mahershaikh1/SAVI_Capstone/PCB_Screenshot.png

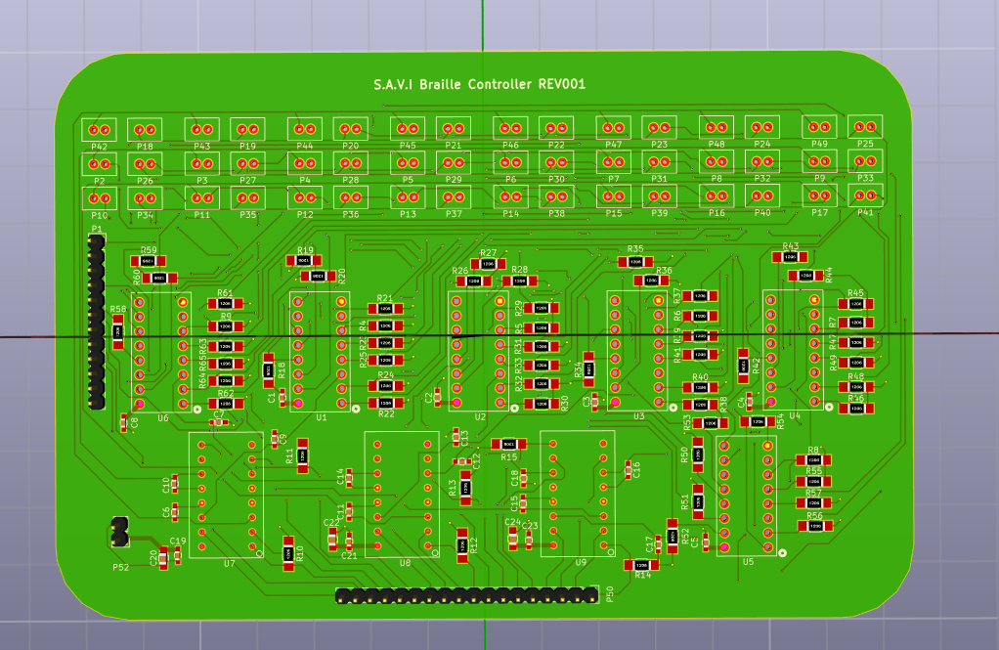
PCB_Screenshot.png
