mahershaikh1/SAVI_Capstone/README.md

# SAVI_Capstone
Smartphone Assistant for the Visually Impaired capstone project. Placed 3rd in the Computer and Electrical Engineering Department.
