mahershaikh1/SAVI_Capstone/Case_SolidWorks/CaseBottom.SLDPRT

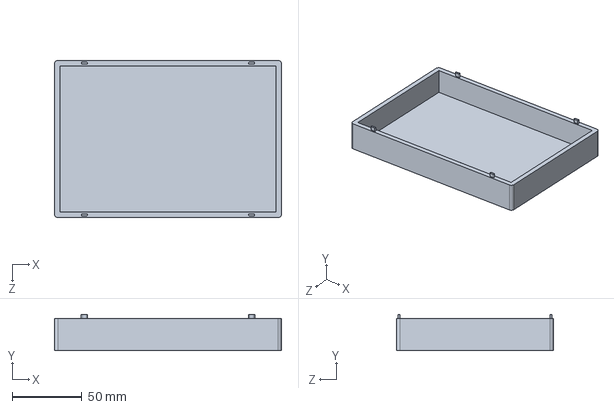
[picture p20: CAD file, 2018-03-02]
Case_SolidWorks/CaseBottom.SLDPRT
163.0 x 26.0 x 113.0 mm
