mahershaikh1/SAVI_Capstone/Pin_Mechanism_stl_files/pin_05.STL

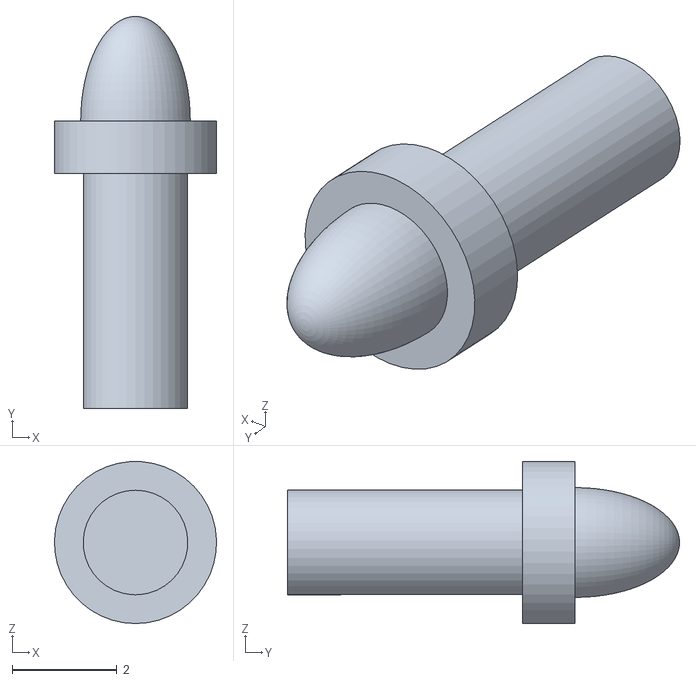
[picture p21: CAD file, 2018-03-02]
Pin_Mechanism_stl_files/pin_05.STL
3.10 x 7.50 x 3.10
