mahershaikh1/SAVI_Capstone/Case_SolidWorks/CaseMiddle.SLDPRT

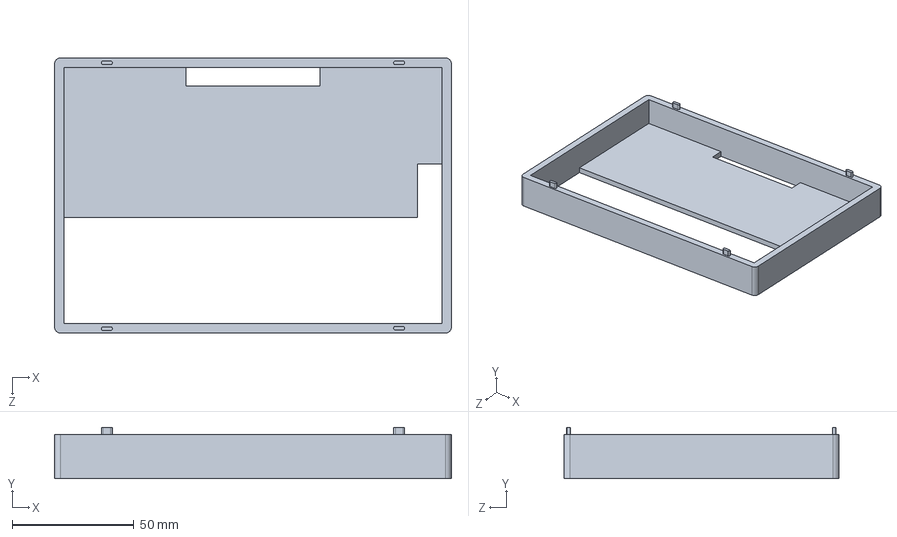
[picture p22: CAD file, 2018-03-02]
Case_SolidWorks/CaseMiddle.SLDPRT
163.0 x 21.0 x 113.0 mm
