mahershaikh1/SAVI_Capstone/Pin_Mechanism_stl_files/fin_0235.STL

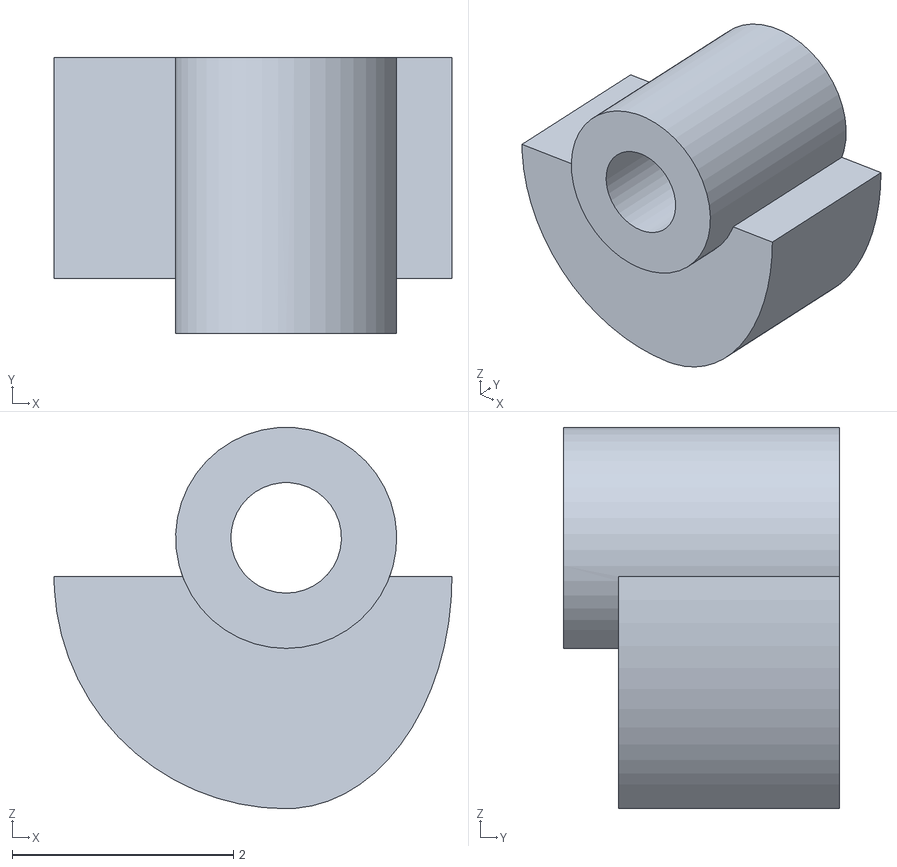
[picture p23: CAD file, 2018-03-02]
Pin_Mechanism_stl_files/fin_0235.STL
3.60 x 2.50 x 3.45
