mahershaikh1/SAVI_Capstone/Case_SolidWorks/CaseTop.SLDPRT

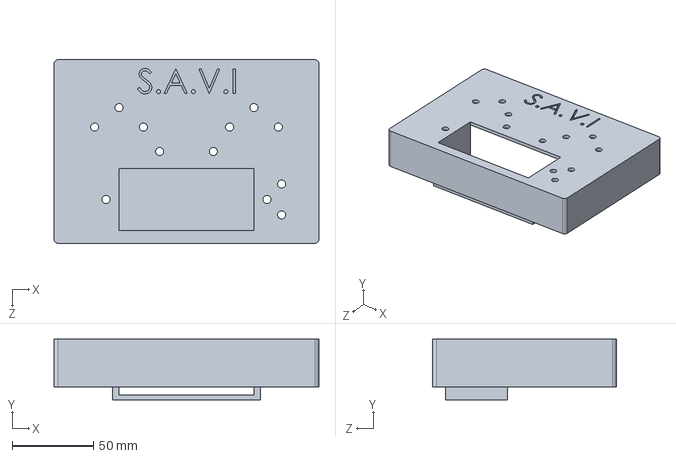
[picture p24: CAD file, 2018-03-02]
Case_SolidWorks/CaseTop.SLDPRT
163.0 x 37.5 x 113.0 mm
