mahershaikh1/SAVI_Capstone/Pin_Mechanism_stl_files/Top_Cover.STL

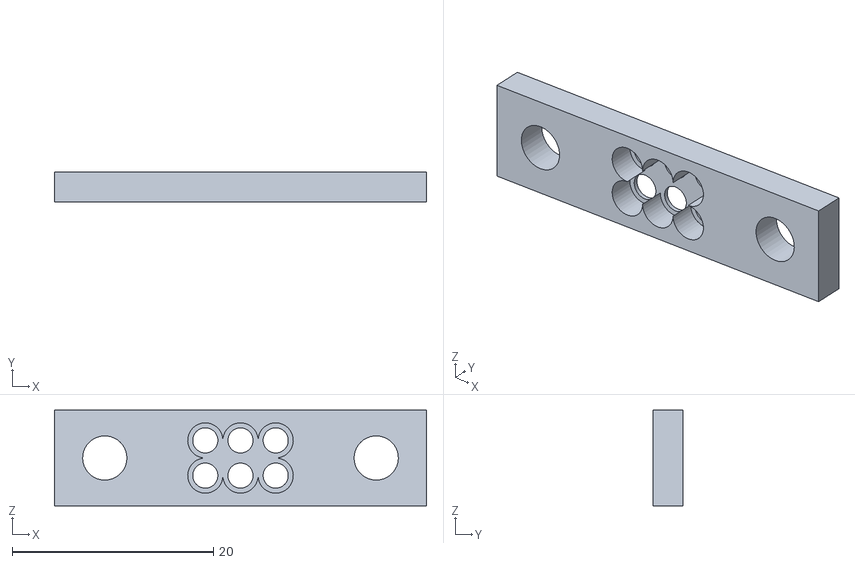
[picture p25: CAD file, 2018-03-02]
Pin_Mechanism_stl_files/Top_Cover.STL
37.0 x 3.00 x 9.50
