mahershaikh1/SAVI_Capstone/Pin_Mechanism_stl_files/pin_1.STL

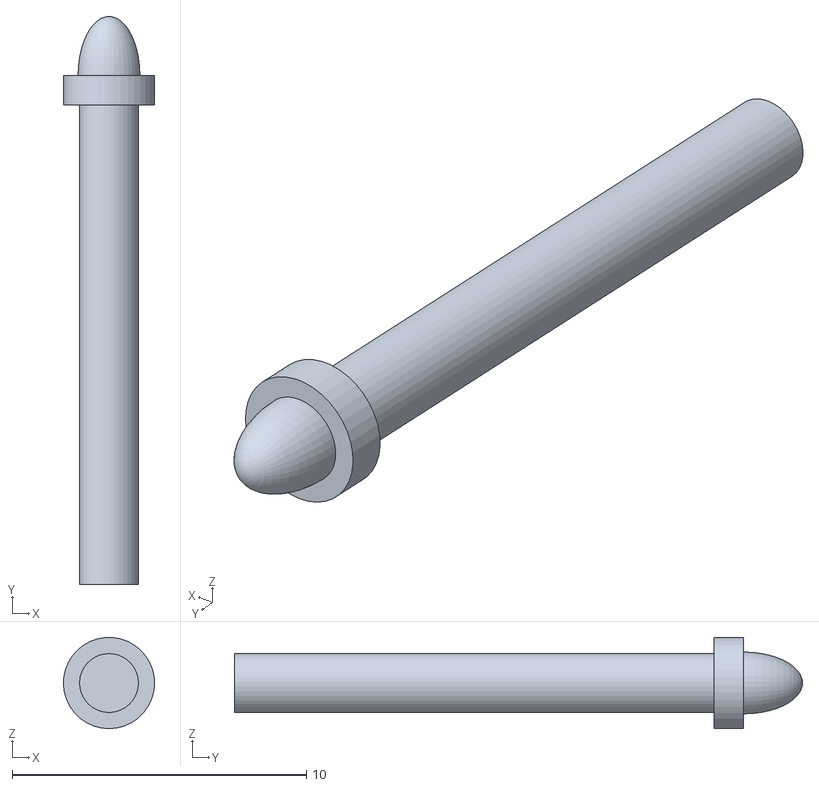
[picture p26: CAD file, 2018-03-02]
Pin_Mechanism_stl_files/pin_1.STL
3.10 x 19.3 x 3.10
