mahershaikh1/SAVI_Capstone/Pin_Mechanism_stl_files/pin_23.STL

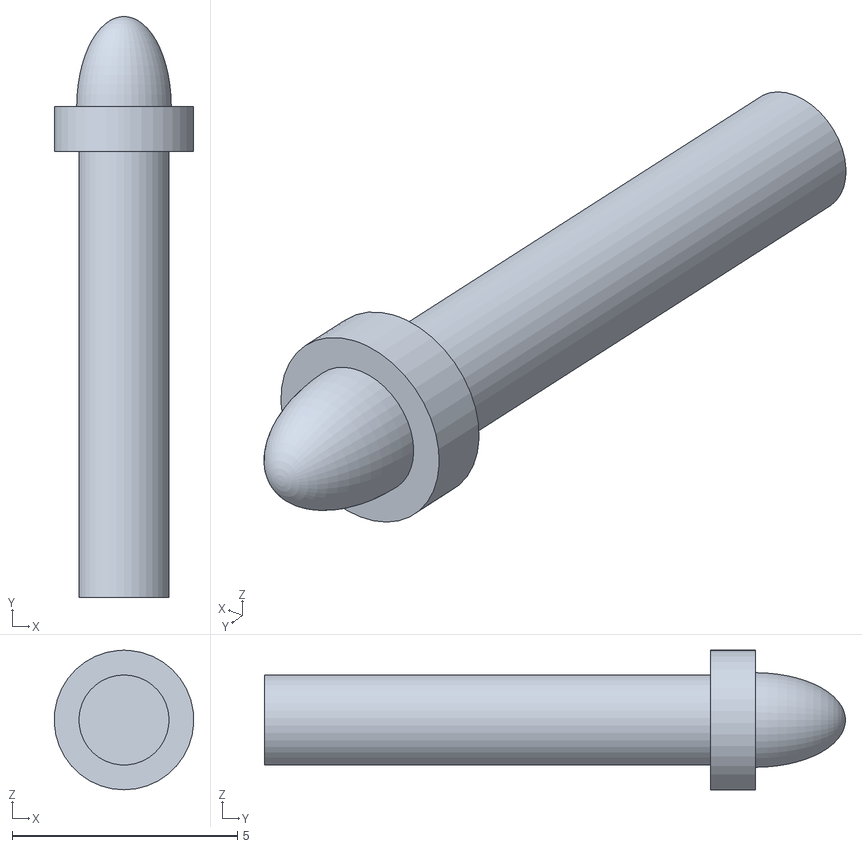
[picture p27: CAD file, 2018-03-02]
Pin_Mechanism_stl_files/pin_23.STL
3.10 x 12.9 x 3.10
