mahershaikh1/SAVI_Capstone/Pin_Mechanism_stl_files/back cover.STL

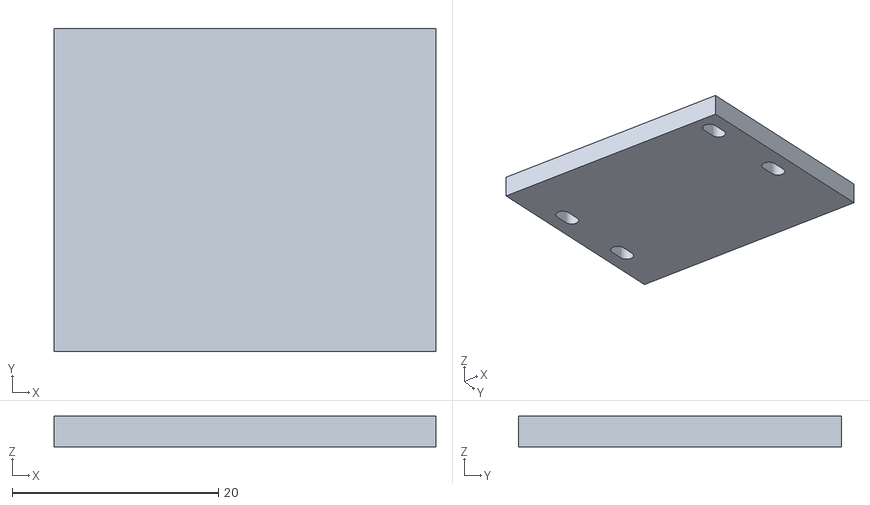
[picture p28: CAD file, 2018-03-02]
Pin_Mechanism_stl_files/back cover.STL
37.0 x 31.3 x 3.00
