mahershaikh1/SAVI_Capstone/Pin_Mechanism_stl_files/housing_middle2.STL

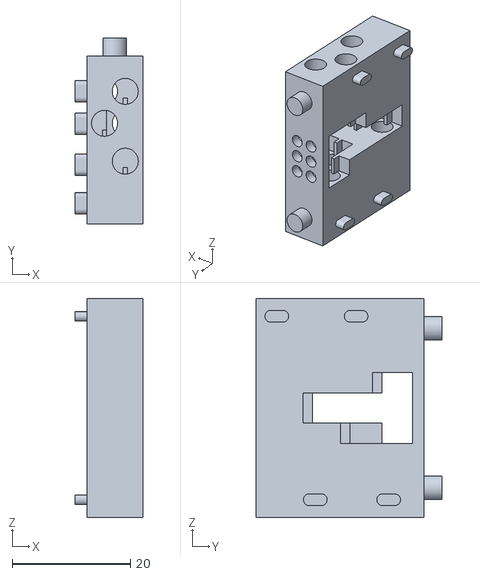
[picture p29: CAD file, 2018-03-02]
Pin_Mechanism_stl_files/housing_middle2.STL
11.5 x 31.4 x 37.0
