mahershaikh1/SAVI_Capstone/Pin_Mechanism_stl_files/front cover.STL

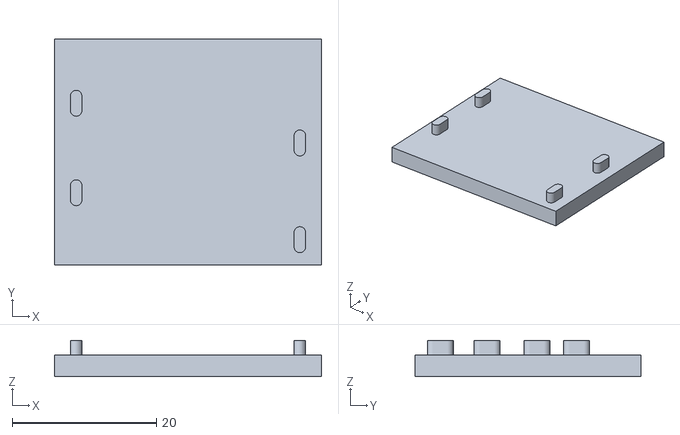
[picture p30: CAD file, 2018-03-02]
Pin_Mechanism_stl_files/front cover.STL
37.0 x 31.3 x 5.00
