mahershaikh1/SAVI_Capstone/Pin_Mechanism_stl_files/pin_4.STL

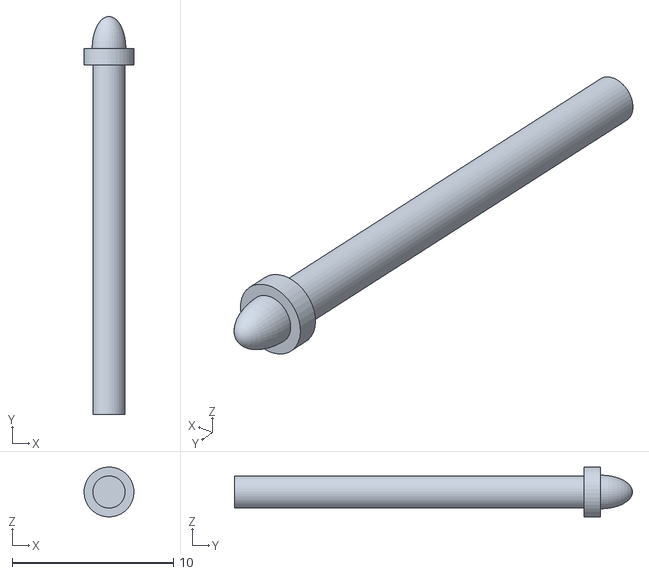
[picture p31: CAD file, 2018-03-02]
Pin_Mechanism_stl_files/pin_4.STL
3.10 x 24.7 x 3.10
