mahershaikh1/SAVI_Capstone/KiCad_PCB_Schematics/Capstone.kicad_pcb

## KiCad design KiCad_PCB_Schematics/Capstone.kicad_pcb (2018-03-02)

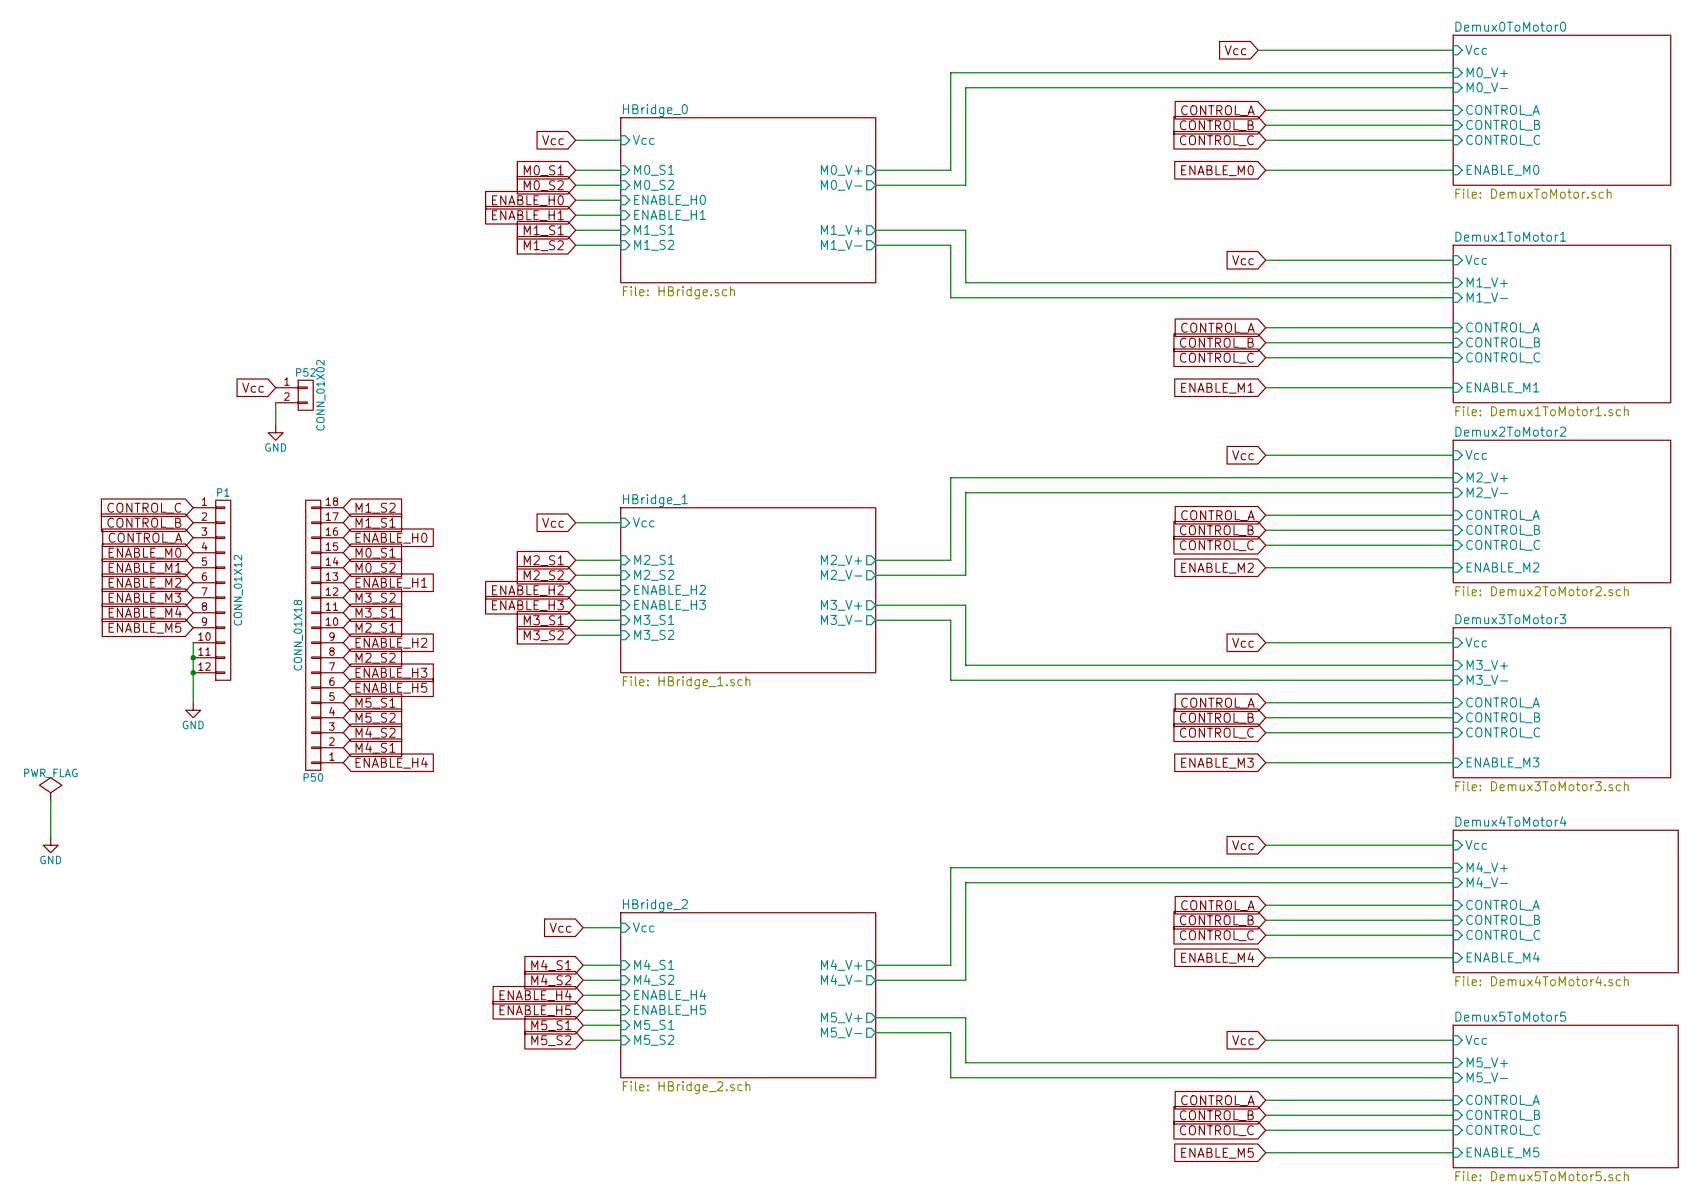
[picture p32: schematic Capstone.sch]

Parts:
P1: CONN_01X12; Pin_Header_Straight_1x12
P50: CONN_01X18; Pin_Header_Straight_1x18
P52: CONN_01X02; Pin_Header_Straight_1x02

Connections:
CONTROL_A: P1.3; also elsewhere on the board
CONTROL_B: P1.2; also elsewhere on the board
CONTROL_C: P1.1; also elsewhere on the board
ENABLE_H0: P50.16; also elsewhere on the board
ENABLE_H1: P50.13; also elsewhere on the board
ENABLE_H2: P50.9; also elsewhere on the board
ENABLE_H3: P50.7; also elsewhere on the board
ENABLE_H4: P50.1; also elsewhere on the board
ENABLE_H5: P50.6; also elsewhere on the board
ENABLE_M0: P1.4; also elsewhere on the board
ENABLE_M1: P1.5; also elsewhere on the board
ENABLE_M2: P1.6; also elsewhere on the board
ENABLE_M3: P1.7; also elsewhere on the board
ENABLE_M4: P1.8; also elsewhere on the board
ENABLE_M5: P1.9; also elsewhere on the board
GND: P1.10, P1.11, P1.12, P52.2; also elsewhere on the board
M0_S1: P50.15; also elsewhere on the board
M0_S2: P50.14; also elsewhere on the board
M1_S1: P50.17; also elsewhere on the board
M1_S2: P50.18; also elsewhere on the board
M2_S1: P50.10; also elsewhere on the board
M2_S2: P50.8; also elsewhere on the board
M3_S1: P50.11; also elsewhere on the board
M3_S2: P50.12; also elsewhere on the board
M4_S1: P50.2; also elsewhere on the board
M4_S2: P50.3; also elsewhere on the board
M5_S1: P50.5; also elsewhere on the board
M5_S2: P50.4; also elsewhere on the board
Vcc: P52.1; also elsewhere on the board

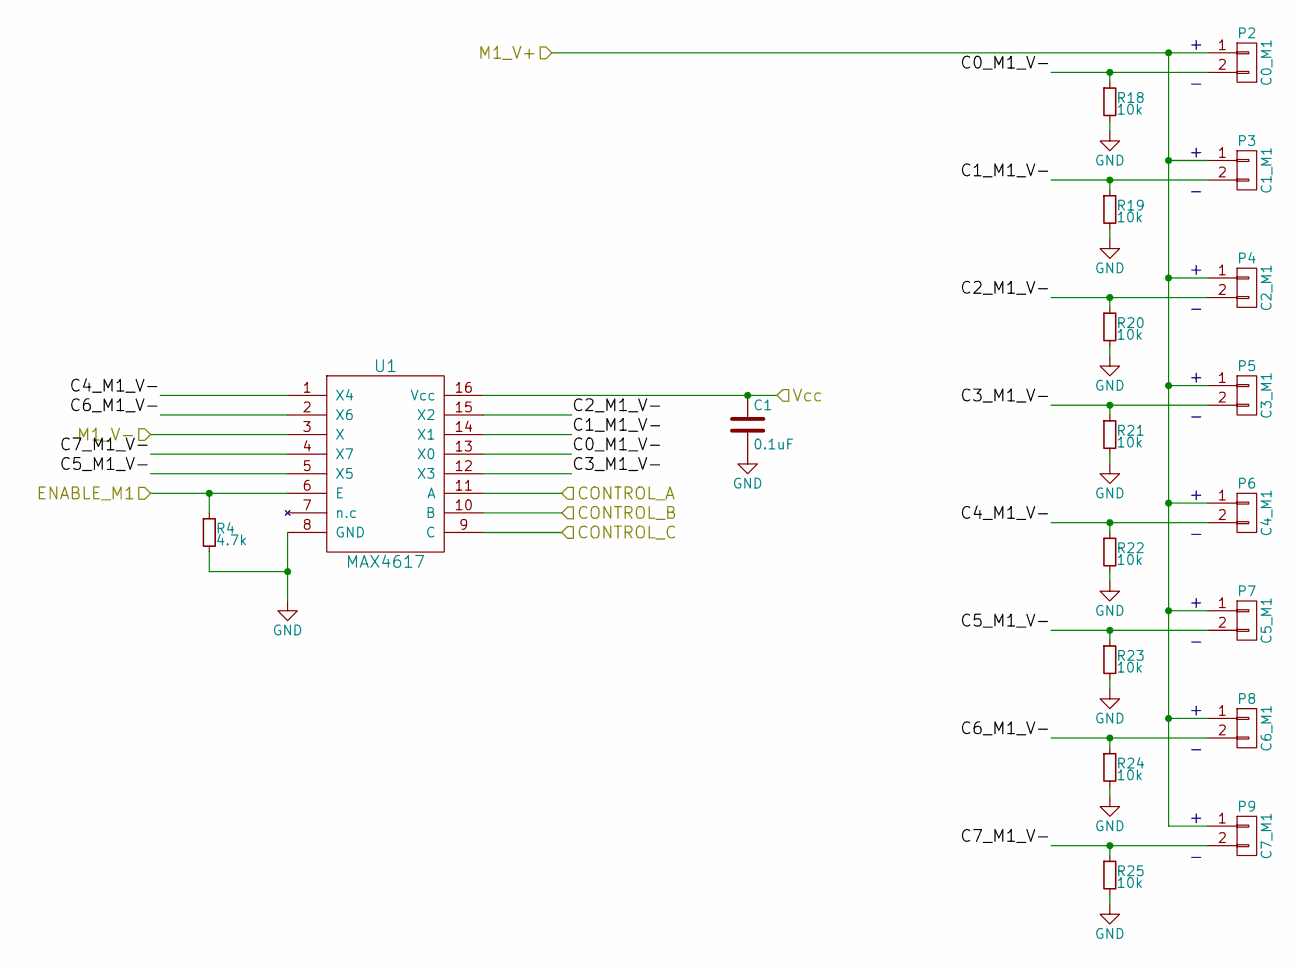
[picture p33: schematic Demux1ToMotor1.sch]

Parts:
C1: 0.1uF; C_0603_HandSoldering
P2: C0_M1; JST_PH
P3: C1_M1; JST_PH
P4: C2_M1; JST_PH
P5: C3_M1; JST_PH
P6: C4_M1; JST_PH
P7: C5_M1; JST_PH
P8: C6_M1; JST_PH
P9: C7_M1; JST_PH
R4: 4.7k; R_1206_HandSoldering
R18, R19, R20, R21, R22, R23, R24, R25: 10k; R_1206_HandSoldering
U1: MAX4617; 16PDIP_Socket

Connections:
/Demux1ToMotor1/C0_M1_V-: P2.2, R18.1, U1.13 (X0)
/Demux1ToMotor1/C1_M1_V-: P3.2, R19.1, U1.14 (X1)
/Demux1ToMotor1/C2_M1_V-: P4.2, R20.1, U1.15 (X2)
/Demux1ToMotor1/C3_M1_V-: P5.2, R21.1, U1.12 (X3)
/Demux1ToMotor1/C4_M1_V-: P6.2, R22.1, U1.1 (X4)
/Demux1ToMotor1/C5_M1_V-: P7.2, R23.1, U1.5 (X5)
/Demux1ToMotor1/C6_M1_V-: P8.2, R24.1, U1.2 (X6)
/Demux1ToMotor1/C7_M1_V-: P9.2, R25.1, U1.4 (X7)
/Demux1ToMotor1/M1_V+: P2.1, P3.1, P4.1, P5.1, P6.1, P7.1, P8.1, P9.1; also elsewhere on the board
/Demux1ToMotor1/M1_V-: U1.3 (X); also elsewhere on the board
CONTROL_A: U1.11 (A); also elsewhere on the board
CONTROL_B: U1.10 (B); also elsewhere on the board
CONTROL_C: U1.9 (C); also elsewhere on the board
ENABLE_M1: R4.1, U1.6 (E); also elsewhere on the board
GND: C1.2, R4.2, R18.2, R19.2, R20.2, R21.2, R22.2, R23.2, R24.2, R25.2, U1.8 (GND); also elsewhere on the board
Vcc: C1.1, U1.16 (Vcc); also elsewhere on the board

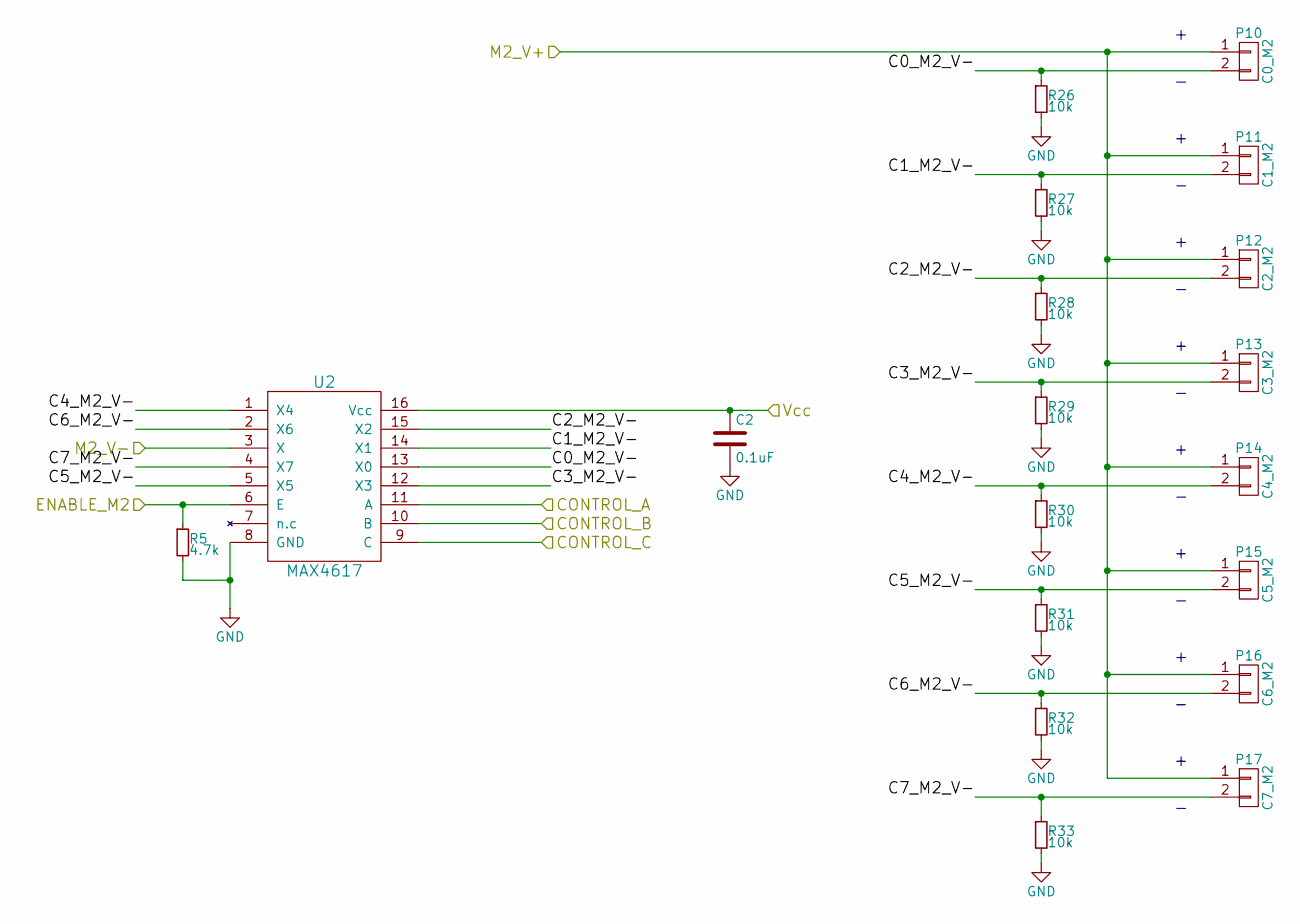
[picture p34: schematic Demux2ToMotor2.sch]

Parts:
C2: 0.1uF; C_0603_HandSoldering
P10: C0_M2; JST_PH
P11: C1_M2; JST_PH
P12: C2_M2; JST_PH
P13: C3_M2; JST_PH
P14: C4_M2; JST_PH
P15: C5_M2; JST_PH
P16: C6_M2; JST_PH
P17: C7_M2; JST_PH
R5: 4.7k; R_1206_HandSoldering
R26, R27, R28, R29, R30, R31, R32, R33: 10k; R_1206_HandSoldering
U2: MAX4617; 16PDIP_Socket

Connections:
/Demux2ToMotor2/C0_M2_V-: P10.2, R26.1, U2.13 (X0)
/Demux2ToMotor2/C1_M2_V-: P11.2, R27.1, U2.14 (X1)
/Demux2ToMotor2/C2_M2_V-: P12.2, R28.1, U2.15 (X2)
/Demux2ToMotor2/C3_M2_V-: P13.2, R29.1, U2.12 (X3)
/Demux2ToMotor2/C4_M2_V-: P14.2, R30.1, U2.1 (X4)
/Demux2ToMotor2/C5_M2_V-: P15.2, R31.1, U2.5 (X5)
/Demux2ToMotor2/C6_M2_V-: P16.2, R32.1, U2.2 (X6)
/Demux2ToMotor2/C7_M2_V-: P17.2, R33.1, U2.4 (X7)
/Demux2ToMotor2/M2_V+: P10.1, P11.1, P12.1, P13.1, P14.1, P15.1, P16.1, P17.1; also elsewhere on the board
/Demux2ToMotor2/M2_V-: U2.3 (X); also elsewhere on the board
CONTROL_A: U2.11 (A); also elsewhere on the board
CONTROL_B: U2.10 (B); also elsewhere on the board
CONTROL_C: U2.9 (C); also elsewhere on the board
ENABLE_M2: R5.1, U2.6 (E); also elsewhere on the board
GND: C2.2, R5.2, R26.2, R27.2, R28.2, R29.2, R30.2, R31.2, R32.2, R33.2, U2.8 (GND); also elsewhere on the board
Vcc: C2.1, U2.16 (Vcc); also elsewhere on the board

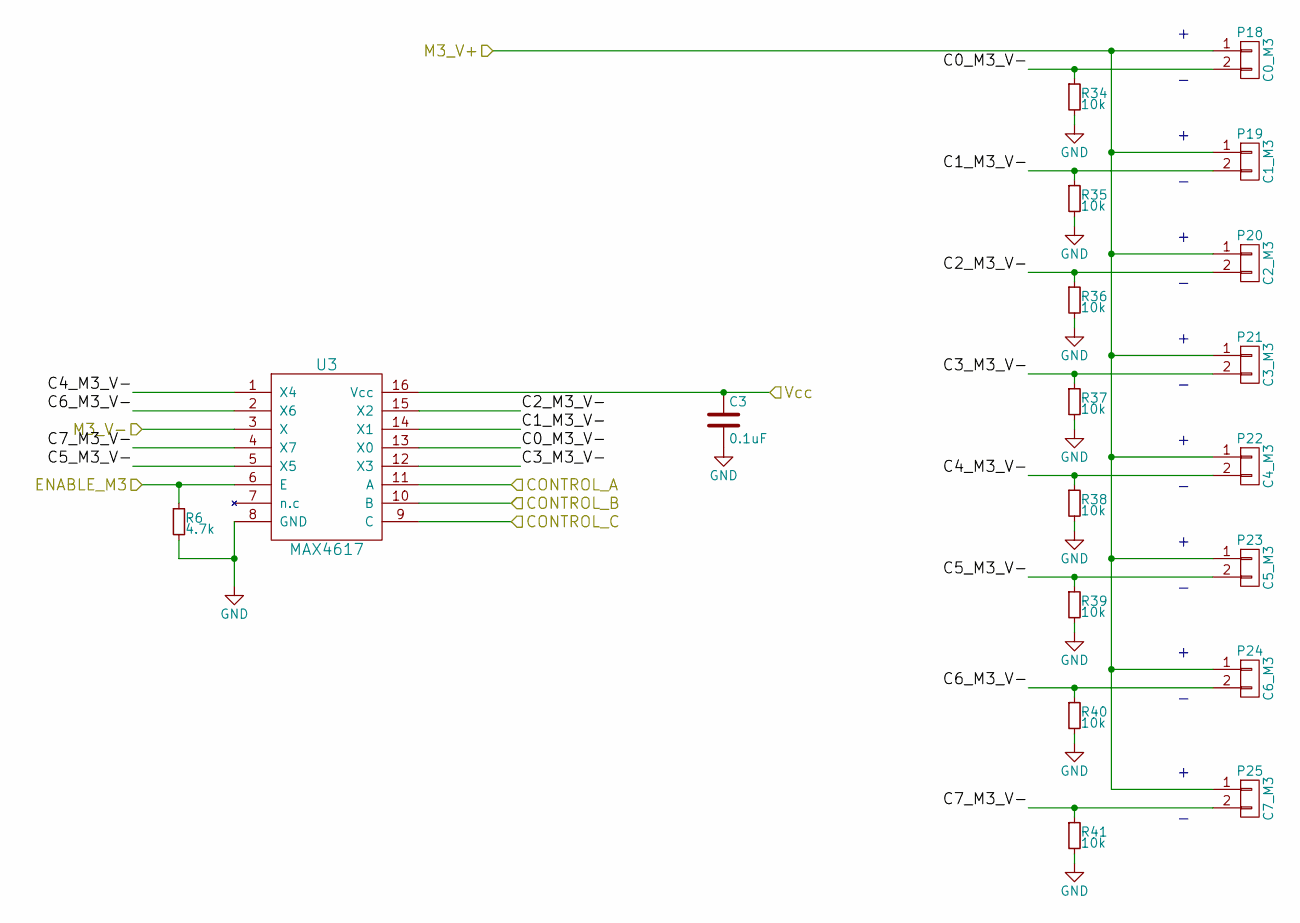
[picture p35: schematic Demux3ToMotor3.sch]

Parts:
C3: 0.1uF; C_0603_HandSoldering
P18: C0_M3; JST_PH
P19: C1_M3; JST_PH
P20: C2_M3; JST_PH
P21: C3_M3; JST_PH
P22: C4_M3; JST_PH
P23: C5_M3; JST_PH
P24: C6_M3; JST_PH
P25: C7_M3; JST_PH
R6: 4.7k; R_1206_HandSoldering
R34, R35, R36, R37, R38, R39, R40, R41: 10k; R_1206_HandSoldering
U3: MAX4617; 16PDIP_Socket

Connections:
/Demux3ToMotor3/C0_M3_V-: P18.2, R34.1, U3.13 (X0)
/Demux3ToMotor3/C1_M3_V-: P19.2, R35.1, U3.14 (X1)
/Demux3ToMotor3/C2_M3_V-: P20.2, R36.1, U3.15 (X2)
/Demux3ToMotor3/C3_M3_V-: P21.2, R37.1, U3.12 (X3)
/Demux3ToMotor3/C4_M3_V-: P22.2, R38.1, U3.1 (X4)
/Demux3ToMotor3/C5_M3_V-: P23.2, R39.1, U3.5 (X5)
/Demux3ToMotor3/C6_M3_V-: P24.2, R40.1, U3.2 (X6)
/Demux3ToMotor3/C7_M3_V-: P25.2, R41.1, U3.4 (X7)
/Demux3ToMotor3/M3_V+: P18.1, P19.1, P20.1, P21.1, P22.1, P23.1, P24.1, P25.1; also elsewhere on the board
/Demux3ToMotor3/M3_V-: U3.3 (X); also elsewhere on the board
CONTROL_A: U3.11 (A); also elsewhere on the board
CONTROL_B: U3.10 (B); also elsewhere on the board
CONTROL_C: U3.9 (C); also elsewhere on the board
ENABLE_M3: R6.1, U3.6 (E); also elsewhere on the board
GND: C3.2, R6.2, R34.2, R35.2, R36.2, R37.2, R38.2, R39.2, R40.2, R41.2, U3.8 (GND); also elsewhere on the board
Vcc: C3.1, U3.16 (Vcc); also elsewhere on the board

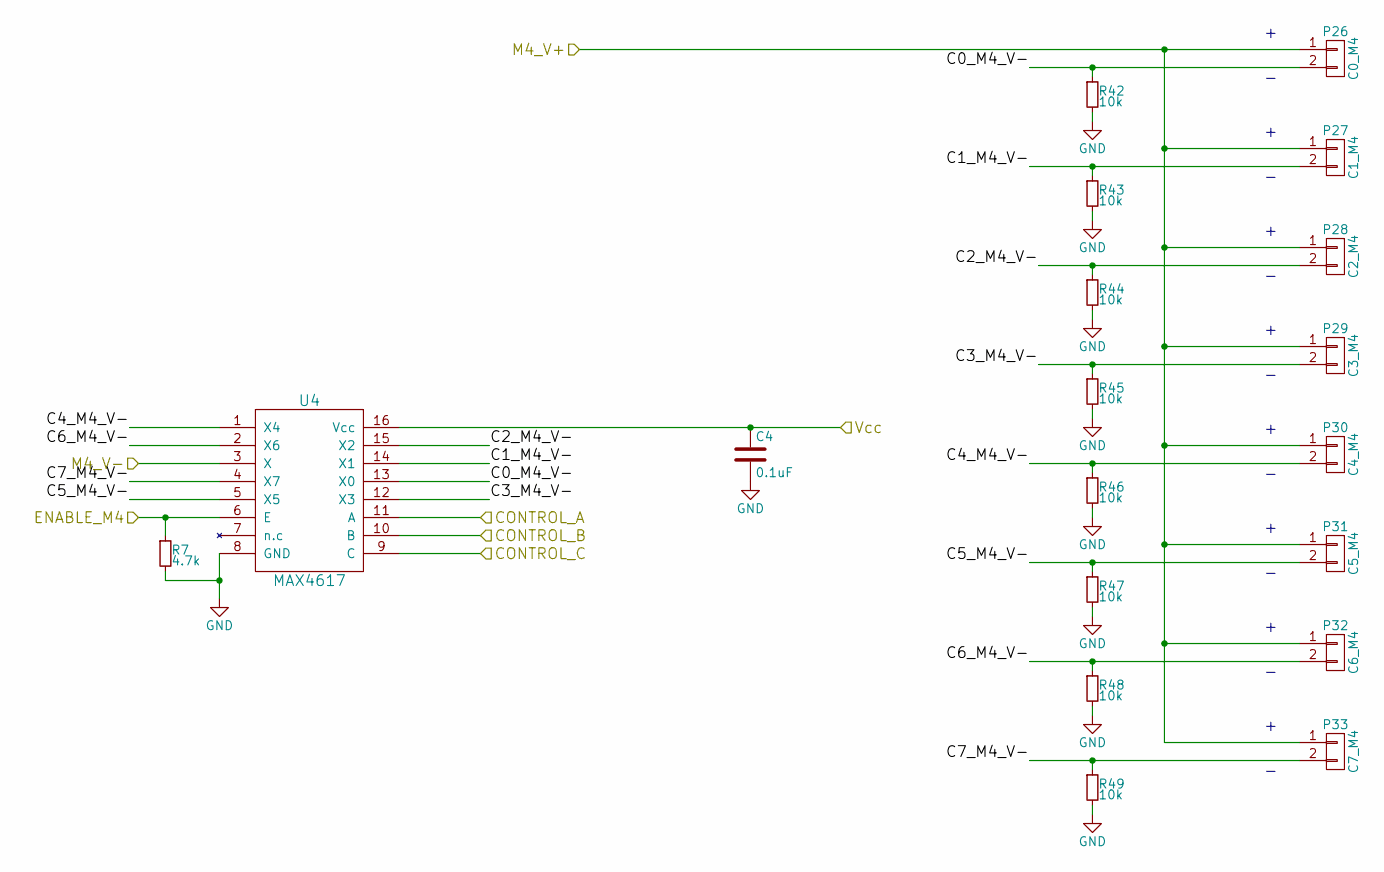
[picture p36: schematic Demux4ToMotor4.sch]

Parts:
C4: 0.1uF; C_0603_HandSoldering
P26: C0_M4; JST_PH
P27: C1_M4; JST_PH
P28: C2_M4; JST_PH
P29: C3_M4; JST_PH
P30: C4_M4; JST_PH
P31: C5_M4; JST_PH
P32: C6_M4; JST_PH
P33: C7_M4; JST_PH
R7: 4.7k; R_1206_HandSoldering
R42, R43, R44, R45, R46, R47, R48, R49: 10k; R_1206_HandSoldering
U4: MAX4617; 16PDIP_Socket

Connections:
/Demux4ToMotor4/C0_M4_V-: P26.2, R42.1, U4.13 (X0)
/Demux4ToMotor4/C1_M4_V-: P27.2, R43.1, U4.14 (X1)
/Demux4ToMotor4/C2_M4_V-: P28.2, R44.1, U4.15 (X2)
/Demux4ToMotor4/C3_M4_V-: P29.2, R45.1, U4.12 (X3)
/Demux4ToMotor4/C4_M4_V-: P30.2, R46.1, U4.1 (X4)
/Demux4ToMotor4/C5_M4_V-: P31.2, R47.1, U4.5 (X5)
/Demux4ToMotor4/C6_M4_V-: P32.2, R48.1, U4.2 (X6)
/Demux4ToMotor4/C7_M4_V-: P33.2, R49.1, U4.4 (X7)
/Demux4ToMotor4/M4_V+: P26.1, P27.1, P28.1, P29.1, P30.1, P31.1, P32.1, P33.1; also elsewhere on the board
/Demux4ToMotor4/M4_V-: U4.3 (X); also elsewhere on the board
CONTROL_A: U4.11 (A); also elsewhere on the board
CONTROL_B: U4.10 (B); also elsewhere on the board
CONTROL_C: U4.9 (C); also elsewhere on the board
ENABLE_M4: R7.1, U4.6 (E); also elsewhere on the board
GND: C4.2, R7.2, R42.2, R43.2, R44.2, R45.2, R46.2, R47.2, R48.2, R49.2, U4.8 (GND); also elsewhere on the board
Vcc: C4.1, U4.16 (Vcc); also elsewhere on the board

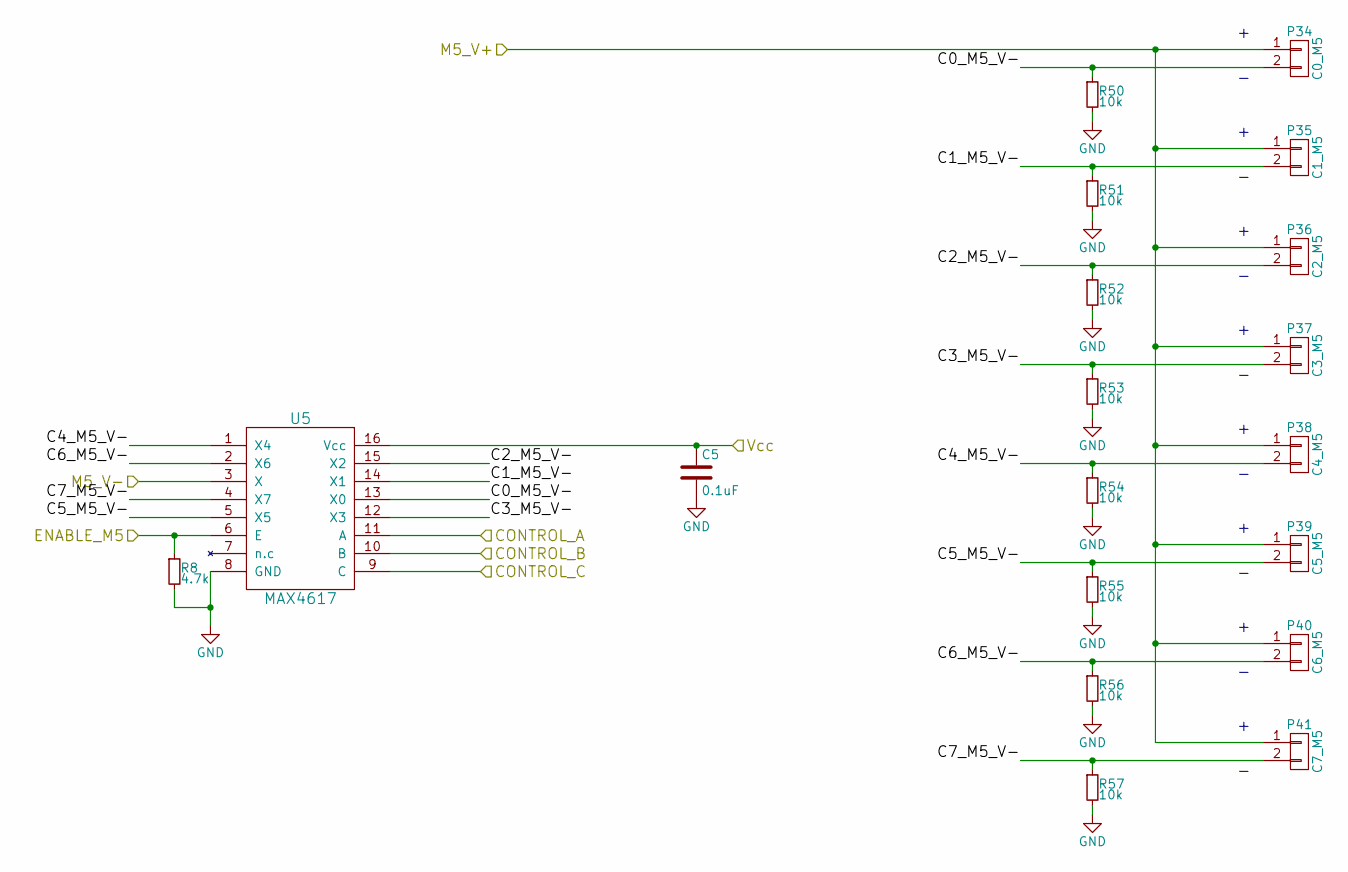
[picture p37: schematic Demux5ToMotor5.sch]

Parts:
C5: 0.1uF; C_0603_HandSoldering
P34: C0_M5; JST_PH
P35: C1_M5; JST_PH
P36: C2_M5; JST_PH
P37: C3_M5; JST_PH
P38: C4_M5; JST_PH
P39: C5_M5; JST_PH
P40: C6_M5; JST_PH
P41: C7_M5; JST_PH
R8: 4.7k; R_1206_HandSoldering
R50, R51, R52, R53, R54, R55, R56, R57: 10k; R_1206_HandSoldering
U5: MAX4617; 16PDIP_Socket

Connections:
/Demux5ToMotor5/C0_M5_V-: P34.2, R50.1, U5.13 (X0)
/Demux5ToMotor5/C1_M5_V-: P35.2, R51.1, U5.14 (X1)
/Demux5ToMotor5/C2_M5_V-: P36.2, R52.1, U5.15 (X2)
/Demux5ToMotor5/C3_M5_V-: P37.2, R53.1, U5.12 (X3)
/Demux5ToMotor5/C4_M5_V-: P38.2, R54.1, U5.1 (X4)
/Demux5ToMotor5/C5_M5_V-: P39.2, R55.1, U5.5 (X5)
/Demux5ToMotor5/C6_M5_V-: P40.2, R56.1, U5.2 (X6)
/Demux5ToMotor5/C7_M5_V-: P41.2, R57.1, U5.4 (X7)
/Demux5ToMotor5/M5_V+: P34.1, P35.1, P36.1, P37.1, P38.1, P39.1, P40.1, P41.1; also elsewhere on the board
/Demux5ToMotor5/M5_V-: U5.3 (X); also elsewhere on the board
CONTROL_A: U5.11 (A); also elsewhere on the board
CONTROL_B: U5.10 (B); also elsewhere on the board
CONTROL_C: U5.9 (C); also elsewhere on the board
ENABLE_M5: R8.1, U5.6 (E); also elsewhere on the board
GND: C5.2, R8.2, R50.2, R51.2, R52.2, R53.2, R54.2, R55.2, R56.2, R57.2, U5.8 (GND); also elsewhere on the board
Vcc: C5.1, U5.16 (Vcc); also elsewhere on the board

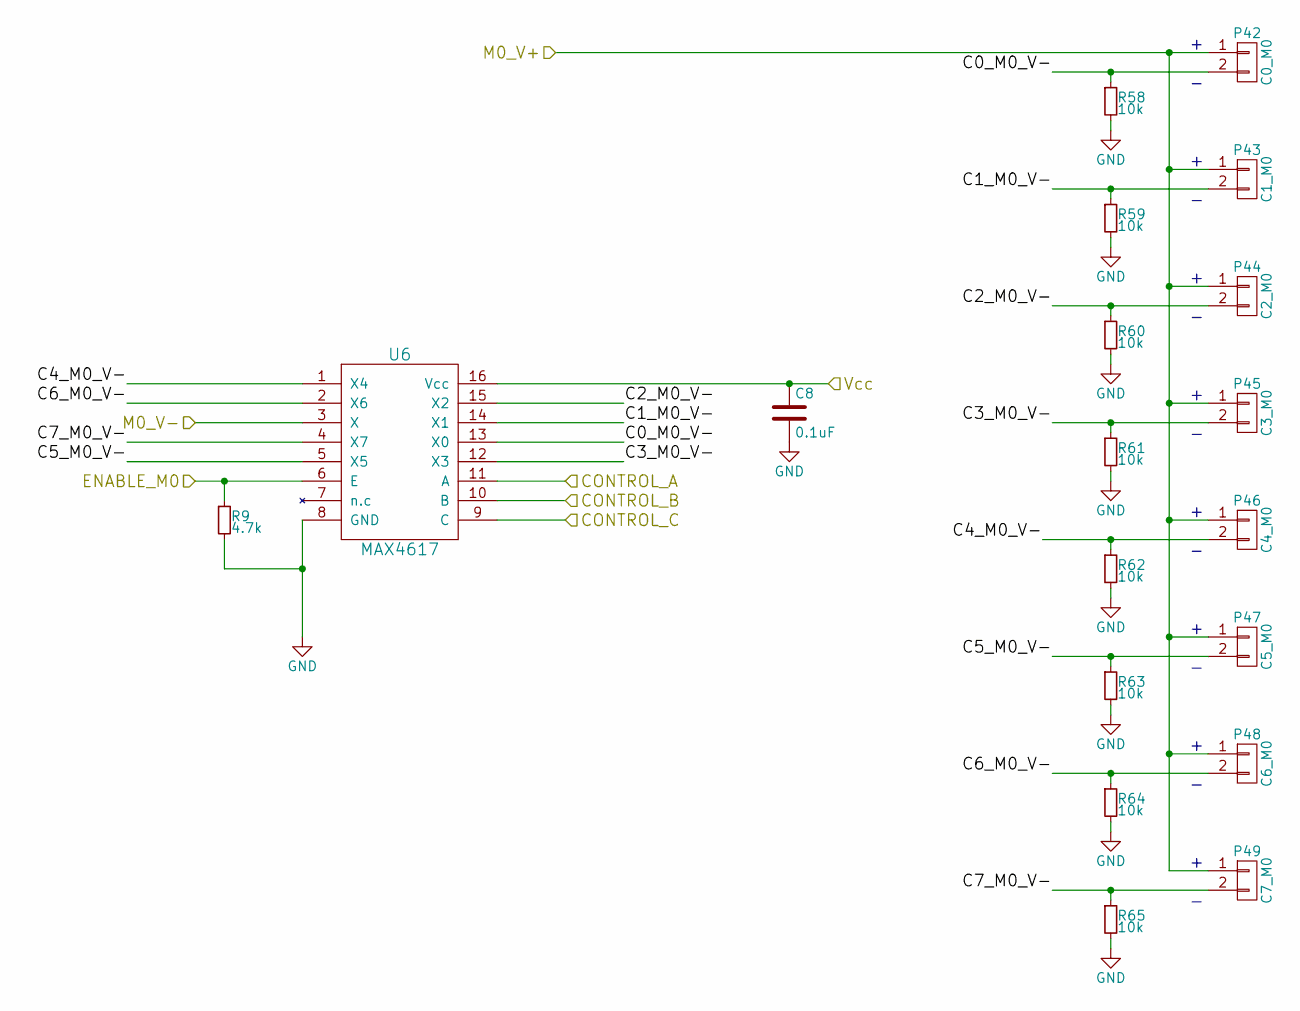
[picture p38: schematic DemuxToMotor.sch]

Parts:
C8: 0.1uF; C_0603_HandSoldering
P42: C0_M0; JST_PH
P43: C1_M0; JST_PH
P44: C2_M0; JST_PH
P45: C3_M0; JST_PH
P46: C4_M0; JST_PH
P47: C5_M0; JST_PH
P48: C6_M0; JST_PH
P49: C7_M0; JST_PH
R9: 4.7k; R_1206_HandSoldering
R58, R59, R60, R61, R62, R63, R64, R65: 10k; R_1206_HandSoldering
U6: MAX4617; 16PDIP_Socket

Connections:
/Demux0ToMotor0/C0_M0_V-: P42.2, R58.1, U6.13 (X0)
/Demux0ToMotor0/C1_M0_V-: P43.2, R59.1, U6.14 (X1)
/Demux0ToMotor0/C2_M0_V-: P44.2, R60.1, U6.15 (X2)
/Demux0ToMotor0/C3_M0_V-: P45.2, R61.1, U6.12 (X3)
/Demux0ToMotor0/C4_M0_V-: P46.2, R62.1, U6.1 (X4)
/Demux0ToMotor0/C5_M0_V-: P47.2, R63.1, U6.5 (X5)
/Demux0ToMotor0/C6_M0_V-: P48.2, R64.1, U6.2 (X6)
/Demux0ToMotor0/C7_M0_V-: P49.2, R65.1, U6.4 (X7)
/Demux0ToMotor0/M0_V+: P42.1, P43.1, P44.1, P45.1, P46.1, P47.1, P48.1, P49.1; also elsewhere on the board
/Demux0ToMotor0/M0_V-: U6.3 (X); also elsewhere on the board
CONTROL_A: U6.11 (A); also elsewhere on the board
CONTROL_B: U6.10 (B); also elsewhere on the board
CONTROL_C: U6.9 (C); also elsewhere on the board
ENABLE_M0: R9.1, U6.6 (E); also elsewhere on the board
GND: C8.2, R9.2, R58.2, R59.2, R60.2, R61.2, R62.2, R63.2, R64.2, R65.2, U6.8 (GND); also elsewhere on the board
Vcc: C8.1, U6.16 (Vcc); also elsewhere on the board

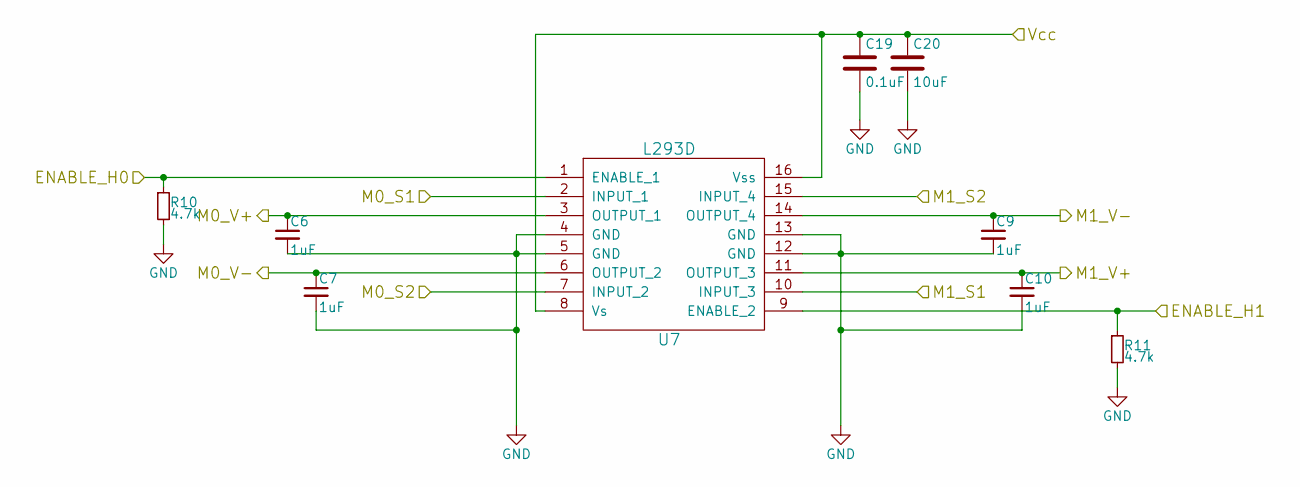
[picture p39: schematic HBridge.sch]

Parts:
C6, C7, C9, C10: 1uF; C_0603_HandSoldering
C19: 0.1uF; C_0603_HandSoldering
C20: 10uF; C_0805_HandSoldering
R10, R11: 4.7k; R_1206_HandSoldering
U7: L293D; L293D_PDIP16

Connections:
/Demux0ToMotor0/M0_V+: C6.1, U7.3 (OUTPUT_1); also elsewhere on the board
/Demux0ToMotor0/M0_V-: C7.1, U7.6 (OUTPUT_2); also elsewhere on the board
/Demux1ToMotor1/M1_V+: C10.1, U7.11 (OUTPUT_3); also elsewhere on the board
/Demux1ToMotor1/M1_V-: C9.1, U7.14 (OUTPUT_4); also elsewhere on the board
ENABLE_H0: R10.1, U7.1 (ENABLE_1); also elsewhere on the board
ENABLE_H1: R11.1, U7.9 (ENABLE_2); also elsewhere on the board
GND: C6.2, C7.2, C9.2, C10.2, C19.2, C20.2, R10.2, R11.2, U7.4 (GND), U7.5 (GND), U7.12 (GND), U7.13 (GND); also elsewhere on the board
M0_S1: U7.2 (INPUT_1); also elsewhere on the board
M0_S2: U7.7 (INPUT_2); also elsewhere on the board
M1_S1: U7.10 (INPUT_3); also elsewhere on the board
M1_S2: U7.15 (INPUT_4); also elsewhere on the board
Vcc: C19.1, C20.1, U7.8 (Vs), U7.16 (Vss); also elsewhere on the board

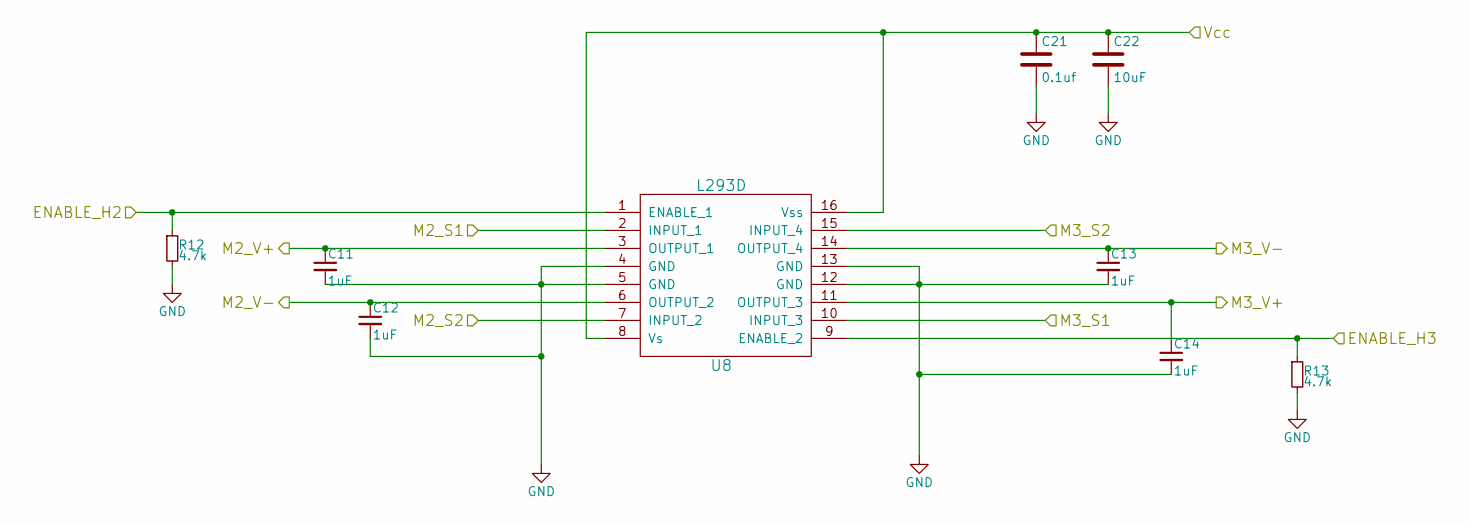
[picture p40: schematic HBridge_1.sch]

Parts:
C11, C12, C13, C14: 1uF; C_0603_HandSoldering
C21: 0.1uf; C_0603_HandSoldering
C22: 10uF; C_0805_HandSoldering
R12, R13: 4.7k; R_1206_HandSoldering
U8: L293D; L293D_PDIP16

Connections:
/Demux2ToMotor2/M2_V+: C11.1, U8.3 (OUTPUT_1); also elsewhere on the board
/Demux2ToMotor2/M2_V-: C12.1, U8.6 (OUTPUT_2); also elsewhere on the board
/Demux3ToMotor3/M3_V+: C14.1, U8.11 (OUTPUT_3); also elsewhere on the board
/Demux3ToMotor3/M3_V-: C13.1, U8.14 (OUTPUT_4); also elsewhere on the board
ENABLE_H2: R12.1, U8.1 (ENABLE_1); also elsewhere on the board
ENABLE_H3: R13.1, U8.9 (ENABLE_2); also elsewhere on the board
GND: C11.2, C12.2, C13.2, C14.2, C21.2, C22.2, R12.2, R13.2, U8.4 (GND), U8.5 (GND), U8.12 (GND), U8.13 (GND); also elsewhere on the board
M2_S1: U8.2 (INPUT_1); also elsewhere on the board
M2_S2: U8.7 (INPUT_2); also elsewhere on the board
M3_S1: U8.10 (INPUT_3); also elsewhere on the board
M3_S2: U8.15 (INPUT_4); also elsewhere on the board
Vcc: C21.1, C22.1, U8.8 (Vs), U8.16 (Vss); also elsewhere on the board

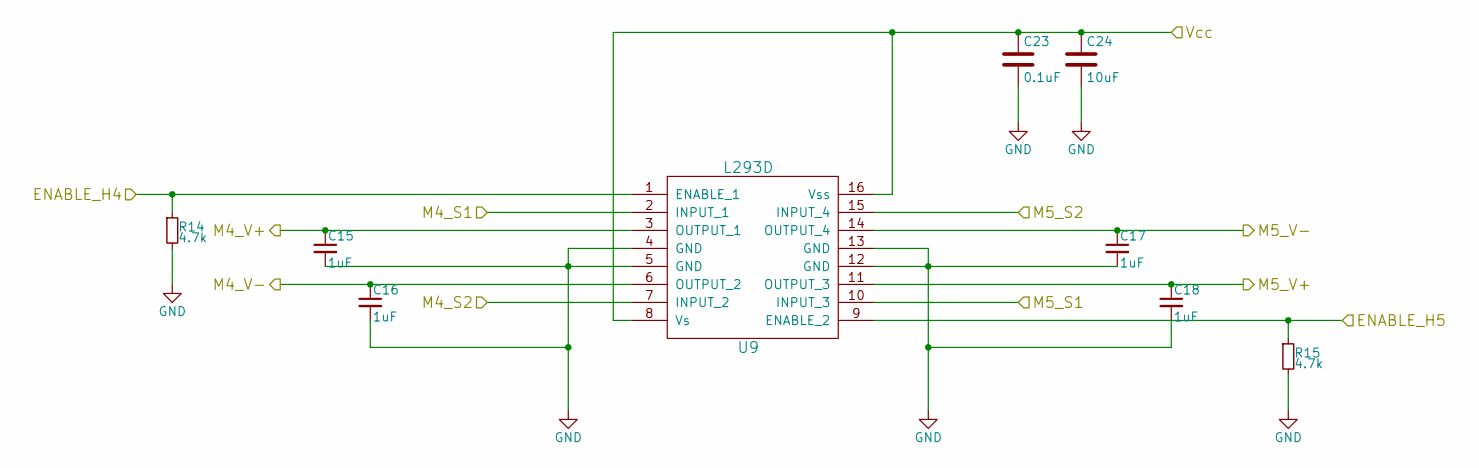
[picture p41: schematic HBridge_2.sch]

Parts:
C15, C16, C17, C18: 1uF; C_0603_HandSoldering
C23: 0.1uF; C_0603_HandSoldering
C24: 10uF; C_0805_HandSoldering
R14, R15: 4.7k; R_1206_HandSoldering
U9: L293D; L293D_PDIP16

Connections:
/Demux4ToMotor4/M4_V+: C15.1, U9.3 (OUTPUT_1); also elsewhere on the board
/Demux4ToMotor4/M4_V-: C16.1, U9.6 (OUTPUT_2); also elsewhere on the board
/Demux5ToMotor5/M5_V+: C18.1, U9.11 (OUTPUT_3); also elsewhere on the board
/Demux5ToMotor5/M5_V-: C17.1, U9.14 (OUTPUT_4); also elsewhere on the board
ENABLE_H4: R14.1, U9.1 (ENABLE_1); also elsewhere on the board
ENABLE_H5: R15.1, U9.9 (ENABLE_2); also elsewhere on the board
GND: C15.2, C16.2, C17.2, C18.2, C23.2, C24.2, R14.2, R15.2, U9.4 (GND), U9.5 (GND), U9.12 (GND), U9.13 (GND); also elsewhere on the board
M4_S1: U9.2 (INPUT_1); also elsewhere on the board
M4_S2: U9.7 (INPUT_2); also elsewhere on the board
M5_S1: U9.10 (INPUT_3); also elsewhere on the board
M5_S2: U9.15 (INPUT_4); also elsewhere on the board
Vcc: C23.1, C24.1, U9.8 (Vs), U9.16 (Vss); also elsewhere on the board

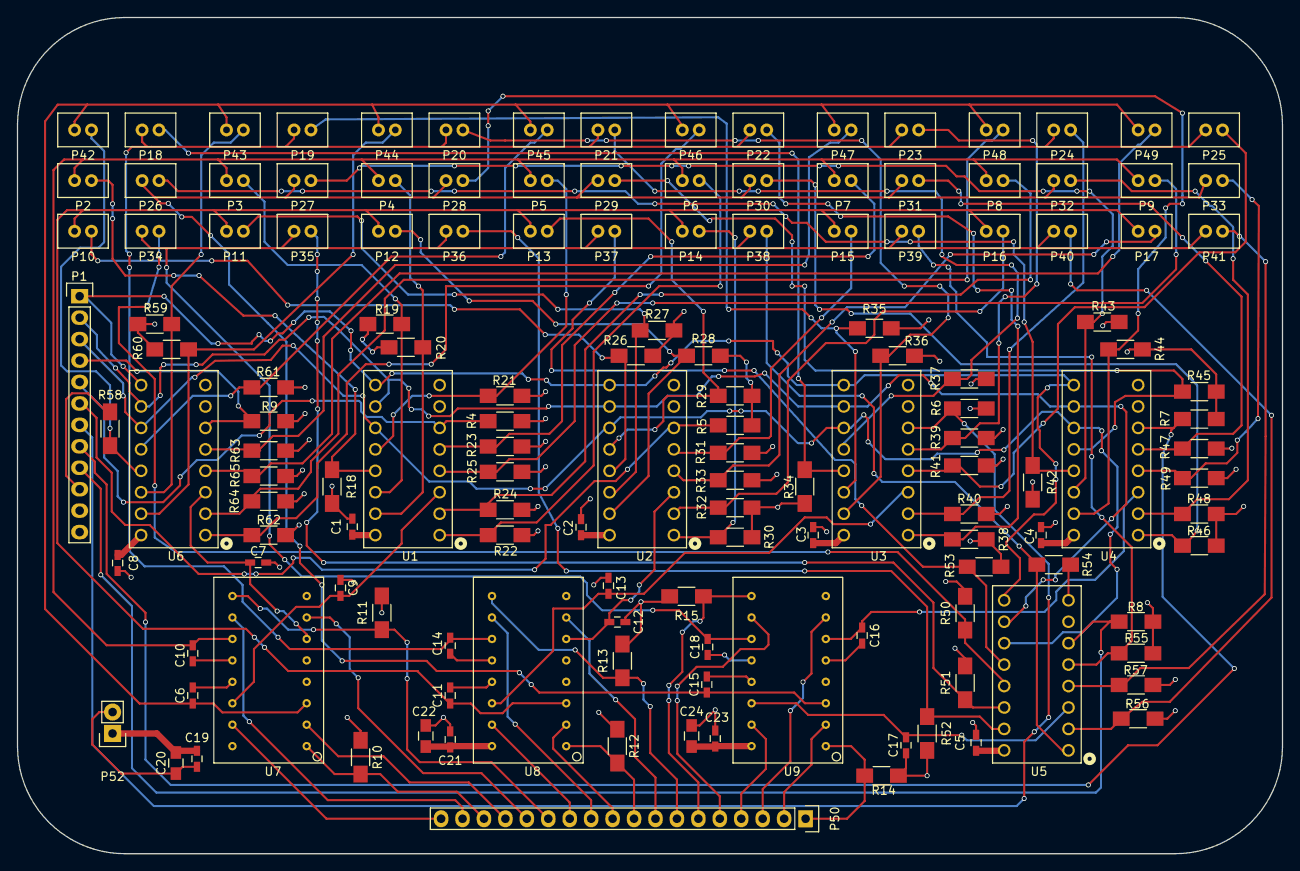
[picture p42: board Capstone.kicad_pcb from above]

Board: 4 copper layers, 149.9 x 99.1 mm, 144 parts (0 on the bottom side), 89 nets.
