mahershaikh1/SAVI_Capstone/(commit log)

2018-03-02 Add files via upload
    SolidWorks Files
    [CaseMiddle.SLDPRT, CaseTop (1).STL, CaseTop.SLDPRT, Top_Cover.STL, back cover.STL, fin_0235.STL, front cover.STL, housing_middle2.STL]
2018-03-02 Add files via upload
    Device case SolidWorks files
    [CaseBottom.SLDPRT, CaseMiddle.SLDPRT, CaseTop.SLDPRT]
2018-03-02 Add files via upload
    All files related to PCB
    [ArduinoMegaPinout.sch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]
2018-03-02 Add files via upload
    Video clips of pin mechanism moving
2018-03-02 Add files via upload
    Screenshot of PCB. Designed in KiCad
2018-03-02 Add files via upload
    Arduino code
